ParaeagleRyanC/nfc-garage-opener/NFC Garage Opener Dev Photos.pdf

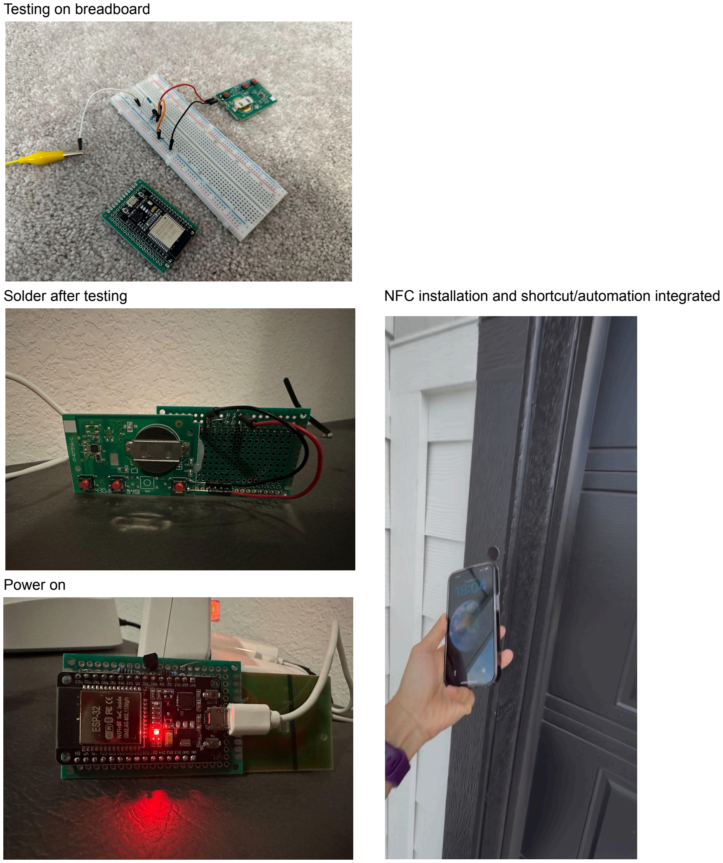
[picture p3: page 1]

Testing on breadboard

Solder after testing | NFC installation and shortcut/automation integrated

Power on

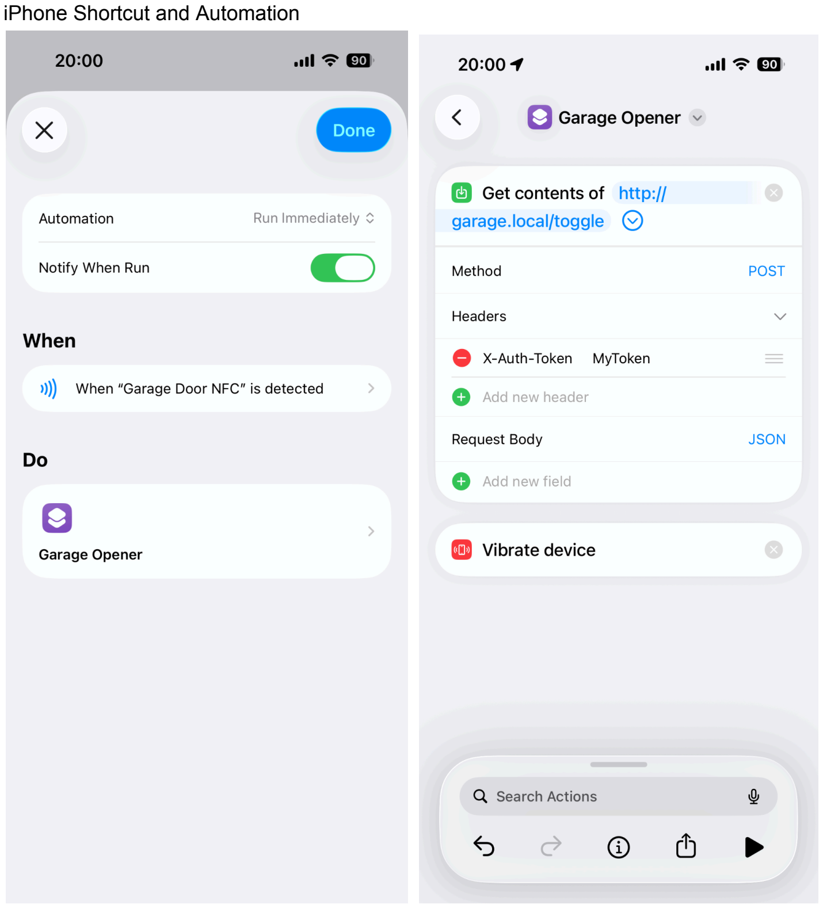
[picture p4: page 2]

iPhone Shortcut and Automation
