ParaeagleRyanC/nfc-garage-opener/wiring_diagram.pdf

## NFC Garage Opener — ESP32 to LiftMaster Remote Wiring

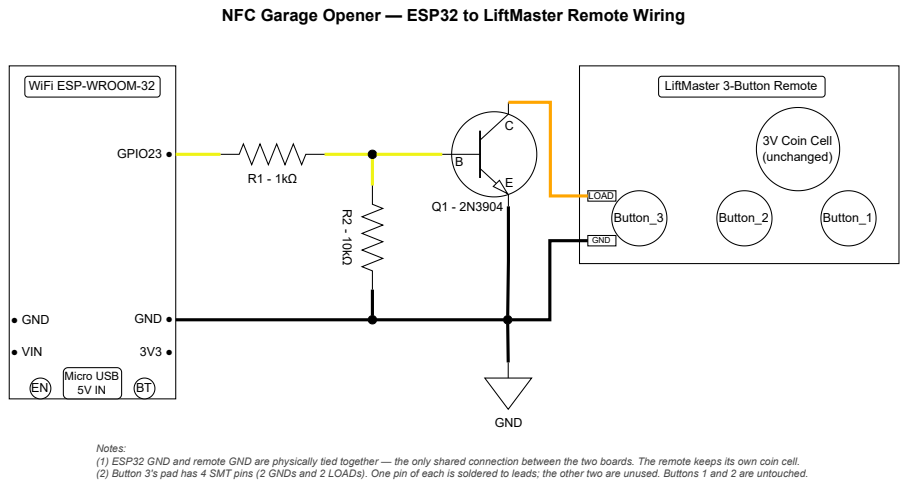
[picture p5: page 1]
GND; GPIO23 ●; GND ●; Micro USB; ● GND; ● VIN; Button_2; Button_1; 3V Coin Cell (unchanged); Button_3; LOAD

WiFi ESP-WROOM-32

LiftMaster 3-Button Remote

Notes:
(1) ESP32 GND and remote GND are physically tied together — the only shared connection between the two boards. The remote keeps its own coin cell.
(2) Button 3's pad has 4 SMT pins (2 GNDs and 2 LOADs). One pin of each is soldered to leads; the other two are unused. Buttons 1 and 2 are untouched.
