ParaeagleRyanC/nfc-garage-opener/system_flow_diagram.pdf

## NFC Garage Opener — End-to-End Flow

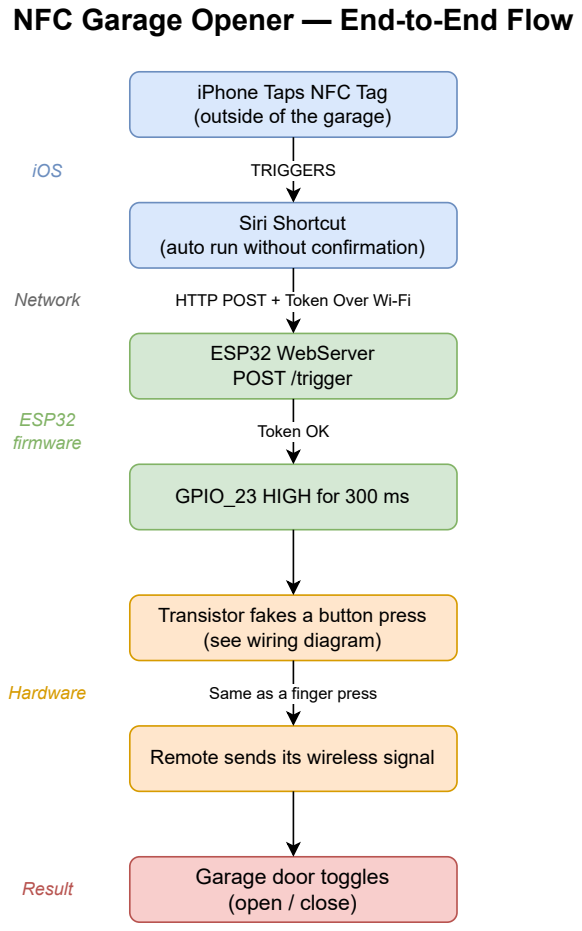
[picture p6: page 1]
iOS; Network; ESP32 firmware; Hardware; Result; Siri Shortcut; ESP32 WebServer POST /trigger; TRIGGERS; Token OK

iPhone Taps NFC Tag
(outside of the garage)

(auto run without confirmation)

HTTP POST + Token Over Wi-Fi

GPIO_23 HIGH for 300 ms

Transistor fakes a button press
(see wiring diagram)

Same as a finger press

Remote sends its wireless signal

Garage door toggles
(open / close)
